PaulBichl/VibePCB-bench-psu/boards/bench-psu/hardware/bench-psu-bom.csv

Qty | Designator | Value | Footprint | MPN | LCSC Part #
14 | C1,C2,C3,C14,C18,C20,C105,C110,C111,C118,C205,C210,C211,C218 | 1uF | tscircuit:capacitor_cap0603 |  | C15849
22 | C4,C11,C17,C19,C21,C22,C104,C112,C114,C115,C116,C117,C119,C120,C204,C212,C214,C215,C216,C217,C219,C220 | 100nF | tscircuit:capacitor_cap0603 |  | C14663
1 | C5 | 4.7nF | tscircuit:capacitor_cap0805 |  | C565695
3 | C6,C25,C26 | 100uF | tscircuit:RVT1V101M0607_100UF_35V | RVT1V101M0607 100UF 35V | C970686
7 | C7,C8,C9,C101,C102,C201,C202 | 10uF | tscircuit:capacitor_cap1206 |  | C13585
3 | C10,C103,C203 | 220nF | tscircuit:capacitor_cap0603 |  | C107083
2 | C12,C13 | 22uF | tscircuit:capacitor_cap0805 |  | C45783
2 | C15,C16 | 10uF | tscircuit:capacitor_cap0805 |  | C15850
10 | C23,C24,C106,C107,C108,C109,C206,C207,C208,C209 | 22uF | tscircuit:capacitor_cap1206 |  | C12891
2 | C113,C213 | 220nF | tscircuit:capacitor_cap0603 |  | C21120
8 | C130,C131,C132,C133,C230,C231,C232,C233 | 33nF | tscircuit:capacitor_cap0603 |  | C21117
1 | D1 | SMBJ22A | tscircuit:SMBJ22A | SMBJ22A | C151920
1 | D2 | ESDA25P35-1U1M | tscircuit:ESDA25P35-1U1M | ESDA25P35-1U1M | C1974707
2 | D13,D23 | SS54 | tscircuit:SS54 | SS54 | C22452
6 | D14,D15,D16,D24,D25,D26 | 1N4148W | tscircuit:1N4148W | 1N4148W | C81598
2 | D101,D201 | KT-0603YG | tscircuit:KT-0603YG | KT-0603YG | C2289
2 | D102,D202 | KT-0603R | tscircuit:KT-0603R | KT-0603R | C2286
2 | ENC1,ENC2 | EC11E15244B2 | tscircuit:EC11E15244B2 | EC11E15244B2 | C470754
1 | J1 | TYPE-C 16PIN 2MD(073) | tscircuit:TYPE-C_16PIN_2MD_073 | TYPE-C 16PIN 2MD(073) | C2765186
1 | J2 | DG301-5.0-04P-14-1000A(H) | tscircuit:DG301-5_0-04P-14-1000A_H | DG301-5.0-04P-14-1000A(H) | C3037697
1 | J3 | PZ254V-11-04P | tscircuit:PZ254V-11-04P | PZ254V-11-04P | C492403
1 | L1 | 6.8µH | tscircuit:FXL0530-6R8-M | FXL0530-6R8-M | C177249
2 | L11,L21 | 15µH | tscircuit:FXL1040-150-M | FXL1040-150-M | C475916
1 | Q1 | AO4407A | tscircuit:AO4407A | AO4407A | C2841482
6 | Q11,Q12,Q14,Q21,Q22,Q24 | MMBT3904(RANGE:100-300) | tscircuit:MMBT3904_RANGE_100-300 | MMBT3904(RANGE:100-300) | C20526
2 | Q13,Q23 | 2N7002 | tscircuit:2N7002 | 2N7002 | C8545
7 | R1,R105,R112,R113,R205,R212,R213 | 1kΩ | tscircuit:resistor_res0603 |  | C21190
1 | R2 | 1MΩ | tscircuit:resistor_res0603 |  | C22935
11 | R3,R4,R5,R107,R109,R120,R126,R207,R209,R220,R226 | 100kΩ | tscircuit:resistor_res0603 |  | C25803
1 | R6 | 24kΩ | tscircuit:resistor_res0603 |  | C23352
7 | R7,R114,R122,R123,R214,R222,R223 | 47kΩ | tscircuit:resistor_res0603 |  | C25819
19 | R9,R10,R13,R106,R108,R110,R115,R116,R117,R119,R124,R206,R208,R210,R215,R216,R217,R219,R224 | 10kΩ | tscircuit:resistor_res0603 |  | C25804
4 | R11,R12,R121,R221 | 4.7kΩ | tscircuit:resistor_res0603 |  | C23162
2 | R101,R201 | 20mΩ | tscircuit:resistor_res2512 |  | C105360
2 | R102,R202 | 120kΩ | tscircuit:resistor_res0603 |  | C25808
2 | R103,R203 | 200kΩ | tscircuit:resistor_res0603 |  | C25811
2 | R104,R204 | 2.2kΩ | tscircuit:resistor_res0603 |  | C4190
2 | R111,R211 | 6.8kΩ | tscircuit:resistor_res0603 |  | C23212
4 | R118,R125,R218,R225 | 330Ω | tscircuit:resistor_res0603 |  | C23138
8 | R130,R131,R132,R133,R230,R231,R232,R233 | 3.3kΩ | tscircuit:resistor_res0603 |  | C22978
2 | SW1,SW2 | TS-1187A-B-A-B | tscircuit:TS-1187A-B-A-B | TS-1187A-B-A-B | C318884
2 | SW13,SW23 | B3F-4055 | tscircuit:B3F-4055 | B3F-4055 | C84931
2 | TH11,TH21 | 10kΩ | tscircuit:NCP18XH103F03RB | NCP18XH103F03RB | C13564
1 | U1 | STUSB4500QTR | tscircuit:STUSB4500QTR | STUSB4500QTR | C2678061
1 | U2 | USBLC6-2SC6 | tscircuit:USBLC6-2SC6 | USBLC6-2SC6 | C2687116
3 | U3,U11,U21 | LMR33630ADDAR | tscircuit:LMR33630ADDAR | LMR33630ADDAR | C841384
1 | U4 | AP2112K-3.3TRG1 | tscircuit:AP2112K-3_3TRG1 | AP2112K-3.3TRG1 | C51118
1 | U5 | ESP32-S3-MINI-1-N8 | tscircuit:ESP32-S3-MINI-1-N8 | ESP32-S3-MINI-1-N8 | C2913206
2 | U6,U7 | TLV9062IDR | tscircuit:TLV9062IDR | TLV9062IDR | C398355
1 | U8 | ESDA25W | tscircuit:ESDA25W | ESDA25W | C2935152
2 | U12,U22 | INA226AIDGSR | tscircuit:INA226AIDGSR | INA226AIDGSR | C49851
2 | U13,U23 | INA181A2IDBVR | tscircuit:INA181A2IDBVR | INA181A2IDBVR | C2058784
