PaulBichl/VibePCB-bench-psu/boards/bench-psu/sim/results/lagsweep.csv

lag_network | vout | phase_margin_deg | min_phase_below_fc_deg | undershoot_mv | tail_after_390us_mv
none | 1.6 | -0.8
none | 3.3 | -14.3
none | 5 | -26.7
none | 12 | -58.0
none | 16 | -70.0
10k / 10 nF | 1.6 | 87.0 | 4.7 | 147.0 | 3.6
10k / 10 nF | 3.3 | 86.6 | -9.9 | 154.9 | 3.6
10k / 10 nF | 5 | 85.9 | -16.2 | 161.5 | 3.7
10k / 10 nF | 12 | 76.6 | -25.8 | 193.2 | 3.9
10k / 10 nF | 16 | 68.7 | -28.0 | 212.9 | 3.9
6.8k / 10 nF | 1.6 | 82.0 | -2.7 | 179.6 | 0.6
6.8k / 10 nF | 3.3 | 86.2 | -16.4 | 190.0 | 1.0
6.8k / 10 nF | 5 | 90.2 | -22.1 | 197.0 | 1.2
6.8k / 10 nF | 12 | 92.9 | -30.8 | 221.8 | 1.4
6.8k / 10 nF | 16 | 89.7 | -32.7 | 240.8 | 1.5
6.8k / 47 nF | 1.6 | 91.6 | 18.6 | 189.7 | 19.3
6.8k / 47 nF | 3.3 | 94.2 | 2.0 | 199.0 | 18.7
6.8k / 47 nF | 5 | 96.8 | -7.0 | 204.3 | 18.6
6.8k / 47 nF | 12 | 96.4 | -23.3 | 223.8 | 18.6
6.8k / 47 nF | 16 | 92.3 | -27.7 | 242.0 | 18.6
6.8k / 220 nF (board) | 1.6 | 93.8 | 34.7 | 192.7 | 9.8
6.8k / 220 nF (board) | 3.3 | 96.0 | 30.8 | 201.7 | 9.6
6.8k / 220 nF (board) | 5 | 98.2 | 25.6 | 206.4 | 9.5
6.8k / 220 nF (board) | 12 | 97.1 | 8.6 | 224.2 | 9.4
6.8k / 220 nF (board) | 16 | 92.8 | 2.4 | 242.2 | 9.3
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
