PaulBichl/VibePCB-bench-psu/boards/bench-psu/sim/results/bode.csv

vout | fb_network | freq_hz | gain_db | phase_deg
1.6 | divider only | 100 | 70.35 | -95.9
1.6 | divider only | 106 | 69.83 | -96.4
1.6 | divider only | 112.3 | 69.31 | -97.0
1.6 | divider only | 118.9 | 68.79 | -97.6
1.6 | divider only | 126 | 68.27 | -98.2
1.6 | divider only | 133.4 | 67.75 | -98.8
1.6 | divider only | 141.3 | 67.22 | -99.5
1.6 | divider only | 149.7 | 66.69 | -100.2
1.6 | divider only | 158.6 | 66.15 | -100.9
1.6 | divider only | 168 | 65.61 | -101.6
1.6 | divider only | 177.9 | 65.07 | -102.4
1.6 | divider only | 188.5 | 64.52 | -103.1
1.6 | divider only | 199.6 | 63.97 | -103.9
1.6 | divider only | 211.5 | 63.41 | -104.8
1.6 | divider only | 224 | 62.85 | -105.6
1.6 | divider only | 237.3 | 62.28 | -106.5
1.6 | divider only | 251.3 | 61.7 | -107.4
1.6 | divider only | 266.2 | 61.11 | -108.4
1.6 | divider only | 282 | 60.52 | -109.3
1.6 | divider only | 298.7 | 59.91 | -110.3
1.6 | divider only | 316.4 | 59.3 | -111.3
1.6 | divider only | 335.2 | 58.68 | -112.3
1.6 | divider only | 355.1 | 58.04 | -113.3
1.6 | divider only | 376.1 | 57.4 | -114.3
1.6 | divider only | 398.4 | 56.74 | -115.4
1.6 | divider only | 422 | 56.08 | -116.4
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
