PaulBichl/VibePCB-bench-psu/boards/bench-psu/sim/results/loadstep.csv

vout | fb_network | t_us | dev_mv
1.6 | divider only | 150.14 | 0.0
1.6 | divider only | 151.14 | 0.0
1.6 | divider only | 152.14 | 0.0
1.6 | divider only | 153.14 | 0.0
1.6 | divider only | 154.14 | 0.0
1.6 | divider only | 155.14 | 0.0
1.6 | divider only | 156.14 | 0.0
1.6 | divider only | 157.14 | 0.0
1.6 | divider only | 158.14 | 0.0
1.6 | divider only | 159.14 | 0.0
1.6 | divider only | 160.14 | 0.0
1.6 | divider only | 161.14 | 0.0
1.6 | divider only | 162.14 | 0.0
1.6 | divider only | 163.14 | 0.0
1.6 | divider only | 164.14 | 0.0
1.6 | divider only | 165.14 | 0.0
1.6 | divider only | 166.14 | 0.0
1.6 | divider only | 167.14 | 0.0
1.6 | divider only | 168.14 | 0.0
1.6 | divider only | 169.14 | 0.0
1.6 | divider only | 170.14 | 0.0
1.6 | divider only | 171.14 | 0.0
1.6 | divider only | 172.14 | 0.0
1.6 | divider only | 173.14 | 0.0
1.6 | divider only | 174.14 | 0.0
1.6 | divider only | 175.14 | 0.0
1.6 | divider only | 176.14 | 0.0
1.6 | divider only | 177.14 | 0.0
1.6 | divider only | 178.14 | 0.0
1.6 | divider only | 179.14 | 0.0
1.6 | divider only | 180.14 | 0.0
1.6 | divider only | 181.14 | 0.0
1.6 | divider only | 182.14 | 0.0
1.6 | divider only | 183.14 | 0.0
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
