PaulBichl/VibePCB-bench-psu/boards/bench-psu/sim/results/loopsummary.csv

vout | fb_network | crossover_khz | phase_margin_deg | min_phase_below_fc_deg | undershoot_mv | overshoot_mv | tail_after_390us_mv | stable
1.6 | divider only | 119.8 | -0.8 | -0.3 |  |  |  | no
1.6 | with lag network | 9.1 | 93.8 | 34.7 | 192.7 | 201.7 | 9.8 | yes
3.3 | divider only | 137.5 | -14.3 | -11.3 |  |  |  | no
3.3 | with lag network | 11.6 | 96.0 | 30.8 | 201.7 | 210.6 | 9.6 | yes
5 | divider only | 154.7 | -26.7 | -23.2 |  |  |  | no
5 | with lag network | 14.6 | 98.2 | 25.6 | 206.4 | 215.4 | 9.5 | yes
12 | divider only | 204.0 | -58.0 | -55.5 |  |  |  | no
12 | with lag network | 28.5 | 97.1 | 8.6 | 224.2 | 233.3 | 9.4 | yes
16 | divider only | 226.7 | -70.0 | -68.7 |  |  |  | no
16 | with lag network | 38.3 | 92.8 | 2.4 | 242.2 | 251.3 | 9.3 | yes
