PaulBichl/VibePCB-bench-psu/boards/bench-psu/hardware/bench-psu-schematic.pdf

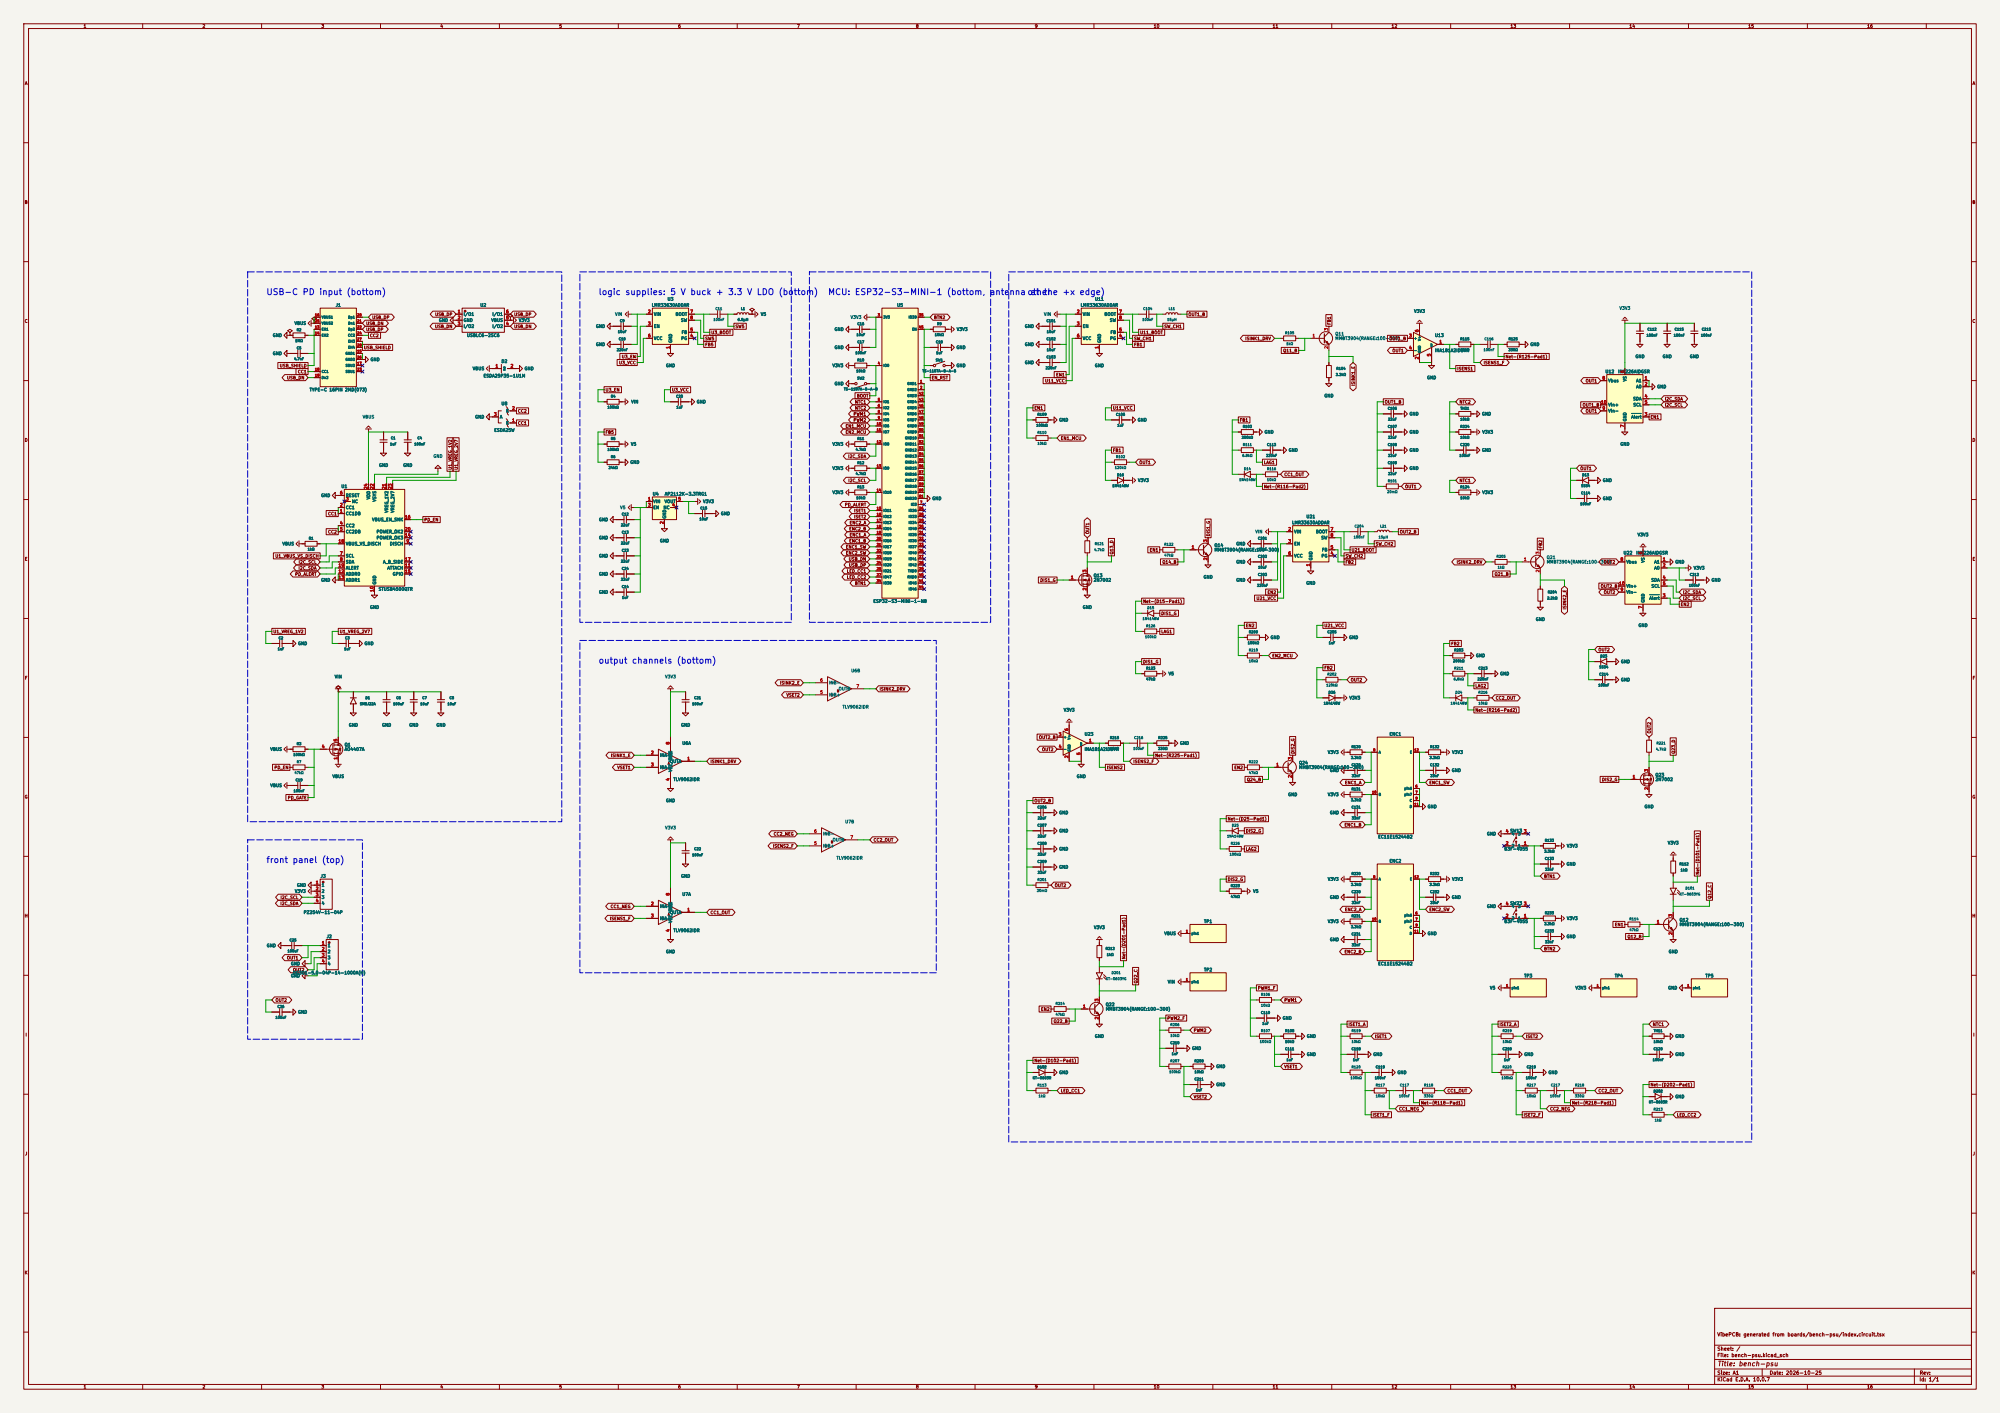
[picture p6: page 1]

VibePCB: generated from boards/bench-psu/index.circuit.tsx

Size: A1 | Rev:
KiCad E.D.A. 10.0.7 | Id: 1/1
