PaulBichl/VibePCB-bench-psu/boards/bench-psu/sim/powerup_ch.cir

* bench-psu rev C: channel power-up and set-point changes through the real VSET network
* run: ngspice -b boards/bench-psu/sim/powerup_ch.cir      (~30 s)
*
* covers: powerup U11 U21
* range: pu_overshoot_pct 0 5 source=house:rules/sim-defaults.toml overshoot_pct (EN at PWM 0, 0 / 1 A; and every set-point step)
* range: pu_settle_ms - 20 source=intent:assumptions "power-up from EN settles within 20 ms" (EN at PWM 0 to 2 % of 1.6 V, incl. the 4 ms soft start)
* range: setpoint_settle_ms - 1000 source=intent:assumptions "set-point changes settle within 1 s" (PWM step to 2 %, via the 2-pole RC)
* range: fb_max_v - 5.5 source=datasheet:LMR33630 SNVSAN3F 7.1 FB abs max 5.5 V (set point 16.6 V -> PWM 0 at no load: the buck cannot sink, the output stays up while the sink current is gone)
* range: vmin_out1 15.77 - source=intent:rail OUT1 16.6 V -5 % (settled output at full PWM through R104 / R106..R108)
*
* Why the sequence matters: the VSET current sink pulls Ic from FB from the moment EN rises, so the output target
* is 1.6 V + 120k * Ic regardless of the converter's soft-start reference. The firmware (README "Firmware duties")
* enables a channel with PWM = 0 (1.6 V, also the reset state), waits for the soft start, then sets the PWM.
*
* Model: the averaged peak-current-mode buck of buck_loop.cir (same assumed internal compensation), its error
* amplifier referenced to a soft-start ramp vref = min(1, t / tss), tss = 4 ms (assumption, SNVSAN3F 3-5 ms typ),
* COMP clamp, PFM variant (no reverse current). Output capacitance at DC bias as in buck_loadpoints.cir.
* Set point as on the board (review board:sims: the deck used to drive the sink current directly and so could not
* see rev B's 15.2 V ceiling): PWM average (0..3.3 V) -> R106 10k -> C110 1 uF -> R107 100k -> VSET (R108 10k,
* C111 1 uF), op-amp + NPN sink Ic = VSET / R104 (2.2k; the op-amp held ideal, its loop is far faster than the RC).
* Lag-capacitor pre-charge as on the board (D15 + R126 from DIS1_G).

.param vt=5 iload=1 tss=4m t1=6m bias=1 tdrop=10 clamp=1
.param duty={(vt - 1.6) / 15}
.param cout={vt < 2 ? 70u : vt < 4 ? 56u : vt < 6 ? 45u : vt < 13 ? 24u : 18u}
.param gm=1m rc=12k cc=4.7n ri=0.1
.param wn={3.14159 * 400k} qs={2 / 3.14159} chn=1n lhn={1 / (wn * wn * chn)} rhn={sqrt(lhn / chn) / qs}

* --- error amplifier against the soft-start reference ---
Bea 0 comp i = gm * (min(1, time / tss) - v(fb))
Roea comp 0 10meg
Rc comp cz {rc}
Cc cz 0 {cc}
Chf comp 0 50p
* COMP clamp (the IC's error amp output is limited; without it the model winds up while FB is above vref)
Dclh comp clh dclamp
Vclh clh 0 0.5
Dcll cll comp dclamp
Vcll cll 0 -0.05
.model dclamp d(is=1e-12 n=0.05)
Bcmd icmd 0 v = min(4.5, max(0, v(comp) / ri))
Rhn icmd hn1 {rhn}
Lhn hn1 ilv {lhn}
Chn ilv 0 {chn}
Bil 0 outb i = v(ilv)
Cout outb co_e {cout}
Rcout co_e 0 0.75m
Rsh outb out 20m
* output bulk at the terminal: C25 (OUT1; C26 on OUT2) 100 uF electrolytic, no DC-bias derating; ESR 0.3 Ohm assumed
* (6.3 x 7.7 mm general-purpose SMD electrolytic, not in the datasheet: ESR-zero ~5 kHz). Checked at 0.05 and 1 Ohm:
* CV phase margin >= 63 deg, CC >= 86 deg, 2 A step <= 323 mV - the result does not hinge on the ESR value.
C25 out cb_e 100u
Resr25 cb_e 0 0.3
* load: iload at the target voltage (resistive), 0 = only the feedback divider and INA inputs
Rload out 0 {iload > 0 ? vt / iload : 1meg}

* --- feedback (R102 / R103, lag R111 + C113), set-point sink ramped by the firmware from t1 over tramp ---
R102 out fb 120k
R103 fb 0 200k
* set point: PWM average from t1 (the firmware sets it after the soft start), filtered as on the board
Vpwm pwm 0 pwl(0 0 {t1} 0 {t1 + 1u} {3.3 * duty} {tdrop} {3.3 * duty} {tdrop + 1u} 0)
R106 pwm pf 10k
C110 pf 0 1u
R107 pf vset 100k
R108 vset 0 10k
C111 vset 0 1u
Efol em 0 vset 0 1
Vis em em2 0
R104 em2 0 2.2k
Bsink fb 0 i = i(Vis)
R111 fb xs 6.8k
C113 xs 0 220n
* lag-capacitor pre-charge while the channel is off (rev C): DIS1_G (the discharge FET's gate, ~4.3 V while EN is
* low, 0.1 V once the NPN Q14 pulls it down at EN) feeds C113 through D15 (1N4148W) + R126 (100k): C113 sits at
* ~1.3 V before EN (R126 swept 68k..180k: overshoot returns above ~165k, settling grows below 100k), so the soft start does not have to charge it through R102. With EN high the diode blocks
* (no offset in operation). bias=0: the rev B network (7.7 V overshoot at every start).
* DIS1_G: 5 V through R123 (47k); Q14 (NPN) pulls it to ~0.1 V once EN is high
V5 v5 0 5
R123 v5 dgn 47k
Ven en 0 pwl(0 0 2u 1)
Snpn dgn 0 en 0 swdis
Rbsel dgn dgb {bias > 0.5 ? 1m : 1e12}
D15 dgb xa dsig
R126 xa xs 100k
.model dsig d(is=2.5n n=1.9 rs=0.6)
* the discharge FET (Q13 + R121 4.7k) holds OUT at 0 V while EN is low
Vctl ctl 0 pwl(0 1 2u 0)
Sdis out dd1 ctl 0 swdis
R121 dd1 0 4.7k
.model swdis sw(vt=0.5 vh=0.1 ron=3 roff=1g)
Cfb fb 0 5p
* FB clamp D16 (1N4148W, FB -> V3V3; review U11:output-voltage): without it FB = 0.625 * OUT (10.4 V at 16.6 V) for
* seconds after a set-point drop or a lost PWM (ESP32 reset), the converter cannot pull the output down
V33 v33 0 3.3
D16 fb dcl dsig
Rclsel dcl v33 {clamp > 0.5 ? 1m : 1e12}

.control
  set noaskquit
  let os_max = 0
  let ts_max = 0
  let ss_max = 0
  let vfull = 0
  echo "power-up at PWM 0 (1.6 V):  Iload | Vmax   overshoot_%  settle_ms"
  foreach i 0 1
    alterparam vt = 1.6
    alterparam iload = $i
    reset
    tran 2u 40m
    meas tran vpk max v(out)
    let os = 100 * (vpk - 1.6) / 1.6
    let os = os > 0 ? os : 0
    let err = abs(v(out) - 1.6) - 0.032
    meas tran tlast when err=0 cross=last
    let ts = tlast * 1000
    echo "  $i | $&vpk $&os $&ts"
    if os > os_max
      let os_max = os
    end
    if ts > ts_max
      let ts_max = ts
    end
    destroy all
  end
  echo "set point (PWM at 6 ms):  Vset Iload | Vend  overshoot_%  settle_ms"
  foreach v 5 16.6
    foreach i 0 1
      alterparam vt = $v
      alterparam iload = $i
      reset
      tran 10u 1.2
      meas tran vend find v(out) at=1.19
      meas tran vpk max v(out)
      let os = 100 * (vpk - vend) / vend
      let os = os > 0 ? os : 0
      let err = abs(v(out) - vend) - 0.02 * vend
      meas tran tlast when err=0 cross=last
      let ss = (tlast - 6m) * 1000
      echo "  $v  $i | $&vend $&os $&ss"
      if os > os_max
        let os_max = os
      end
      if ss > ss_max
        let ss_max = ss
      end
      if $v > 16
        let vfull = vend
      end
      destroy all
    end
  end
  echo "set point 16.6 V -> PWM 0 at 0.4 s, no load:  clamp | FB max"
  let fbmax = 0
  foreach c 0 1
    alterparam vt = 16.6
    alterparam iload = 0
    alterparam tdrop = 0.4
    alterparam clamp = $c
    reset
    tran 10u 1.2
    meas tran fbpk max v(fb) from=0.4 to=1.2
    echo "  $c | $&fbpk"
    if $c > 0
      let fbmax = fbpk
    end
    destroy all
  end
  echo "fb_max_v = $&fbmax"
  echo "pu_overshoot_pct = $&os_max"
  echo "pu_settle_ms = $&ts_max"
  echo "setpoint_settle_ms = $&ss_max"
  echo "vmin_out1 = $&vfull"
.endc
.end
