PaulBichl/VibePCB-bench-psu/boards/bench-psu/hardware/kicad/bench-psu.kicad_pcb

## KiCad design boards/bench-psu/hardware/kicad/bench-psu.kicad_pcb (2026-10-25)

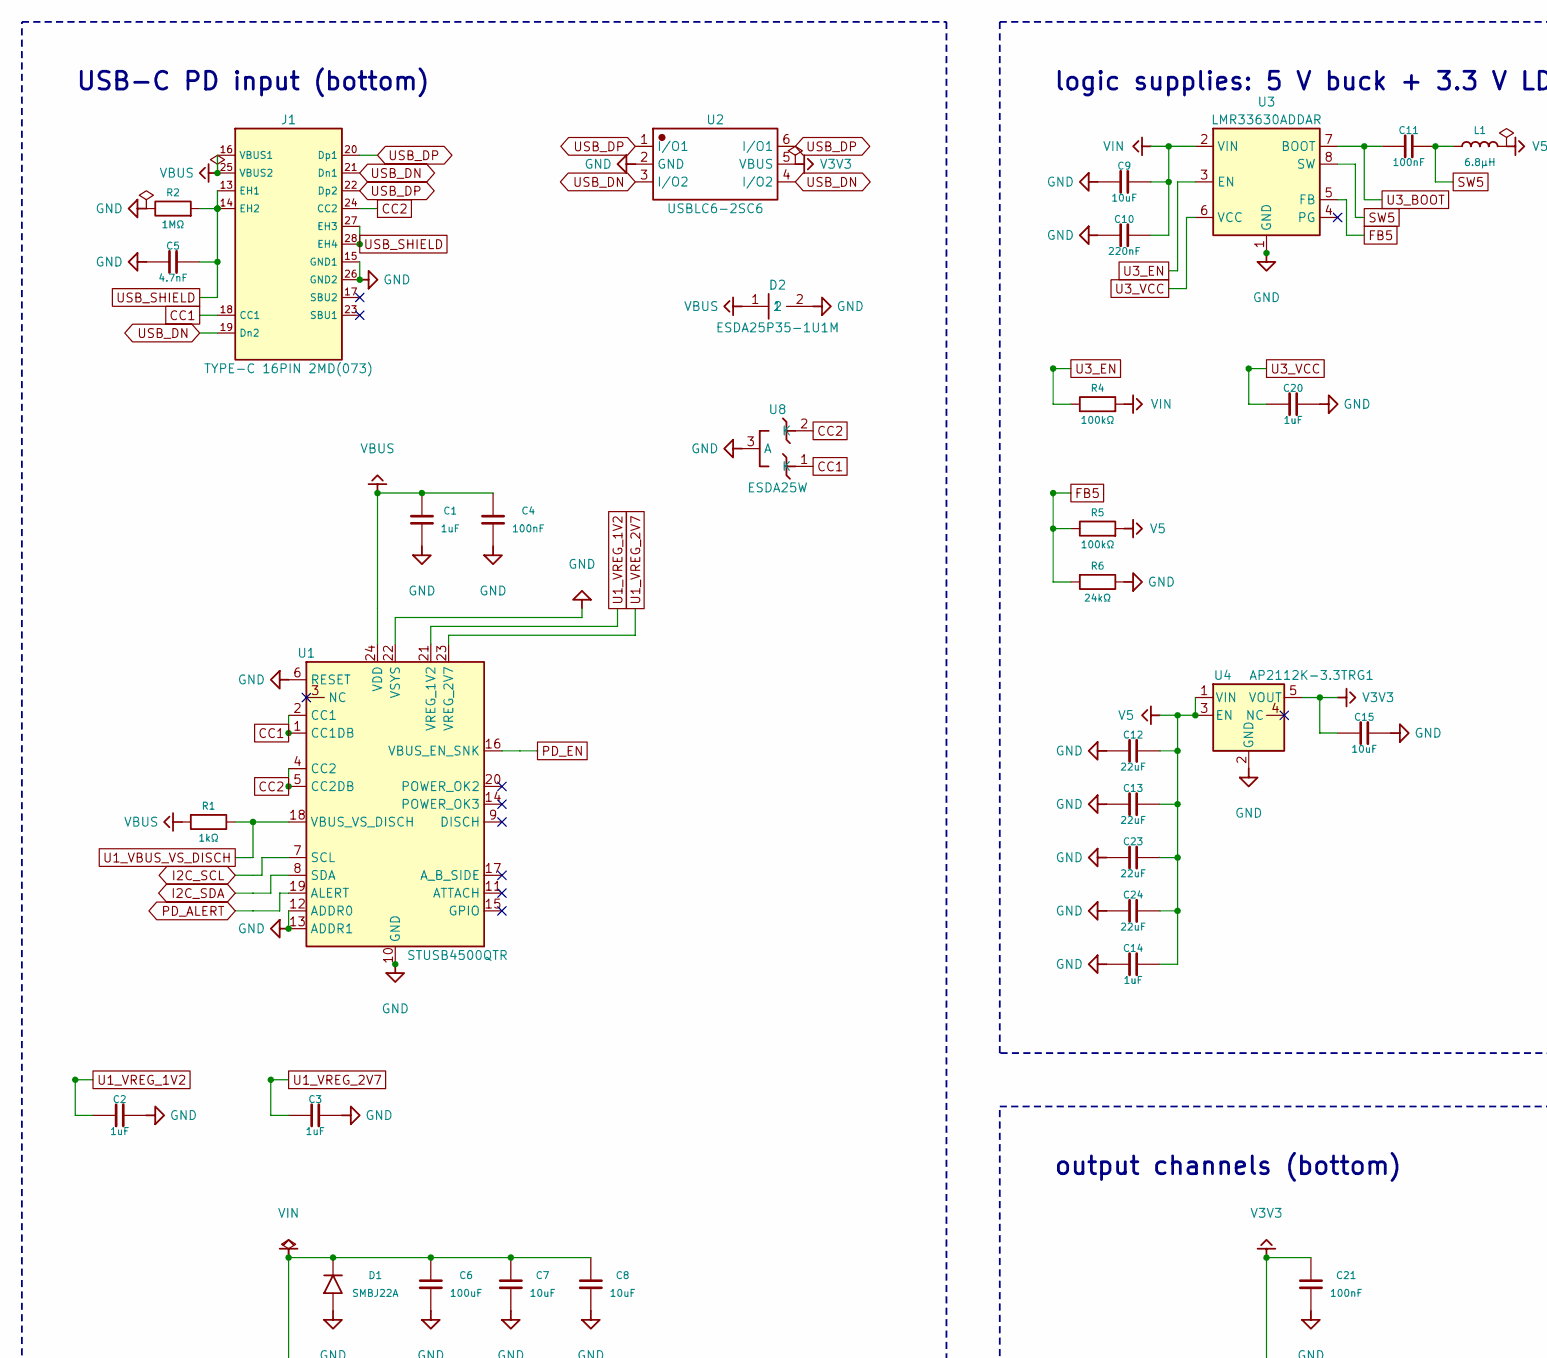
[picture p11: schematic bench-psu.kicad_sch, part in row 1, column 1]

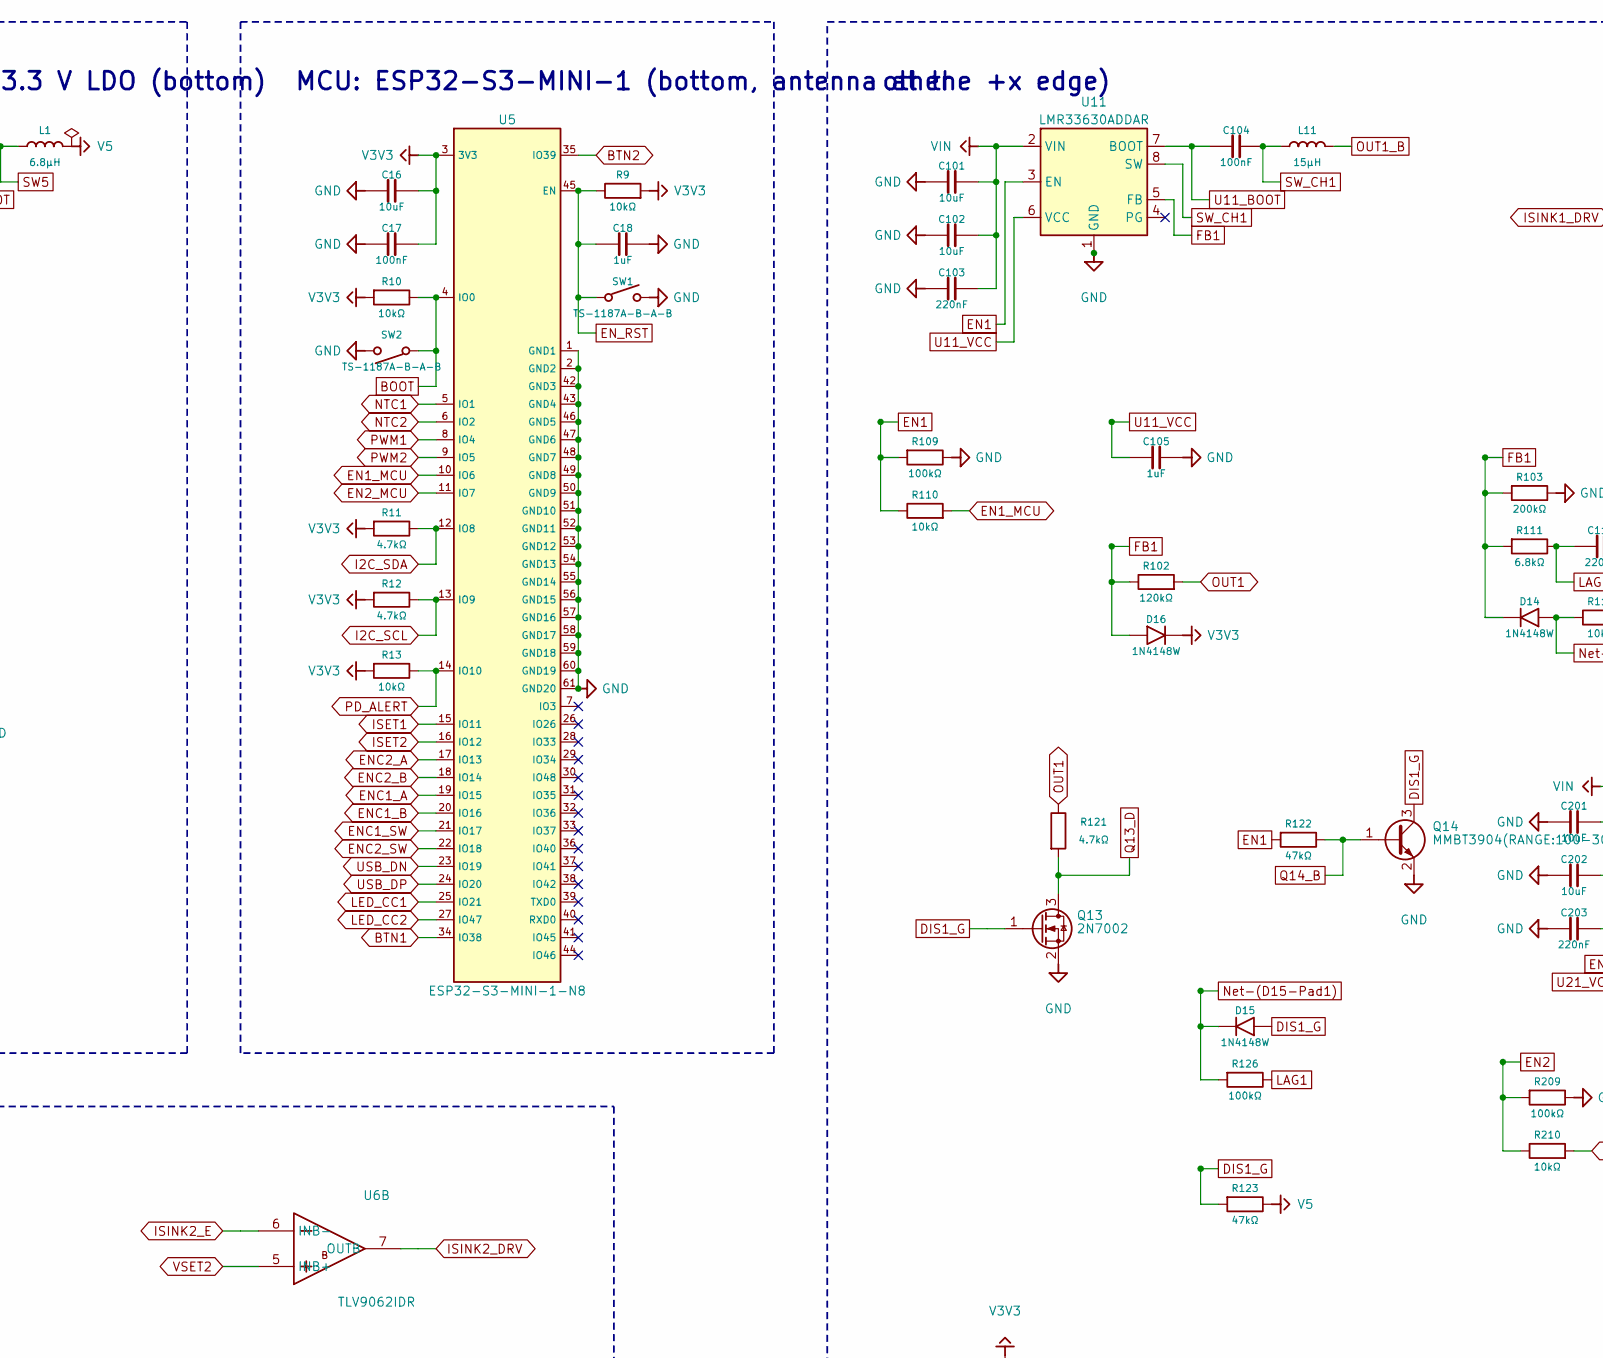
[picture p12: schematic bench-psu.kicad_sch, part in row 1, column 2]

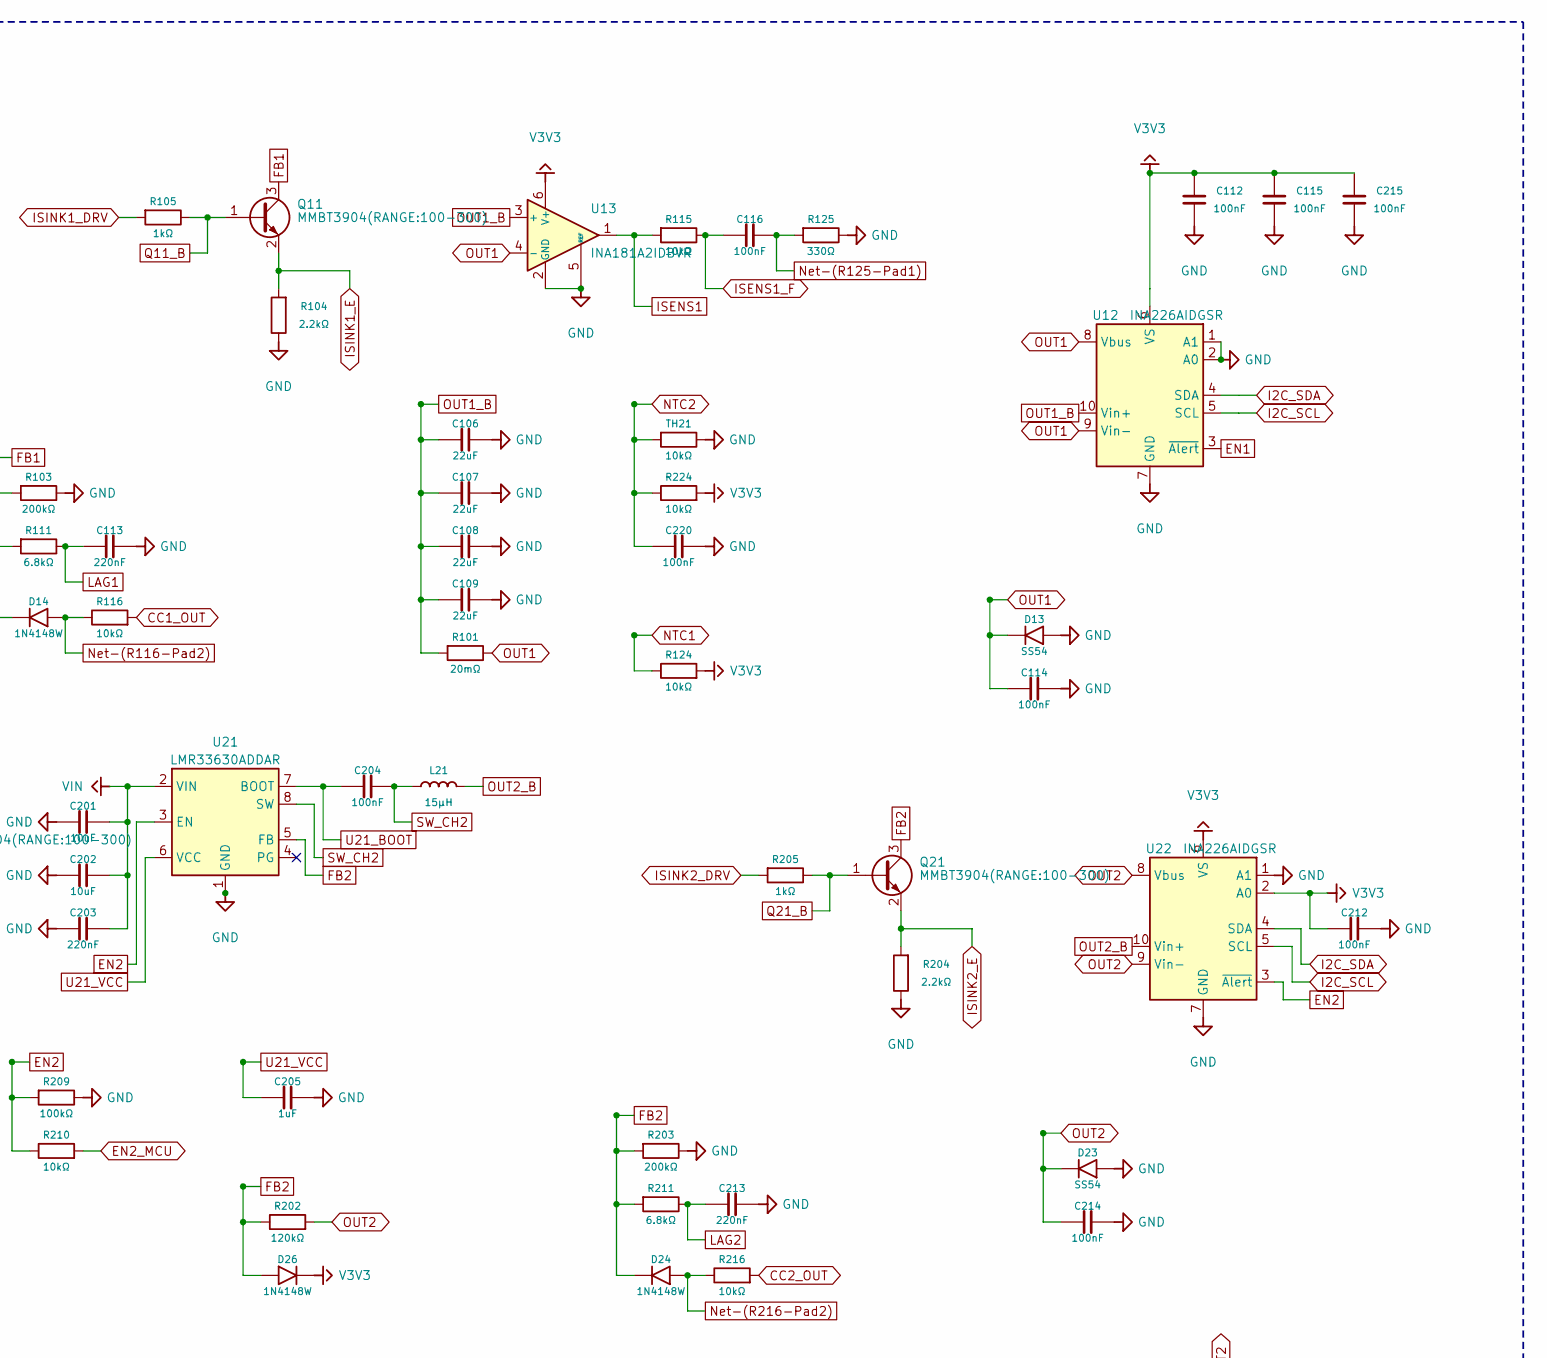
[picture p13: schematic bench-psu.kicad_sch, part in row 1, column 3]

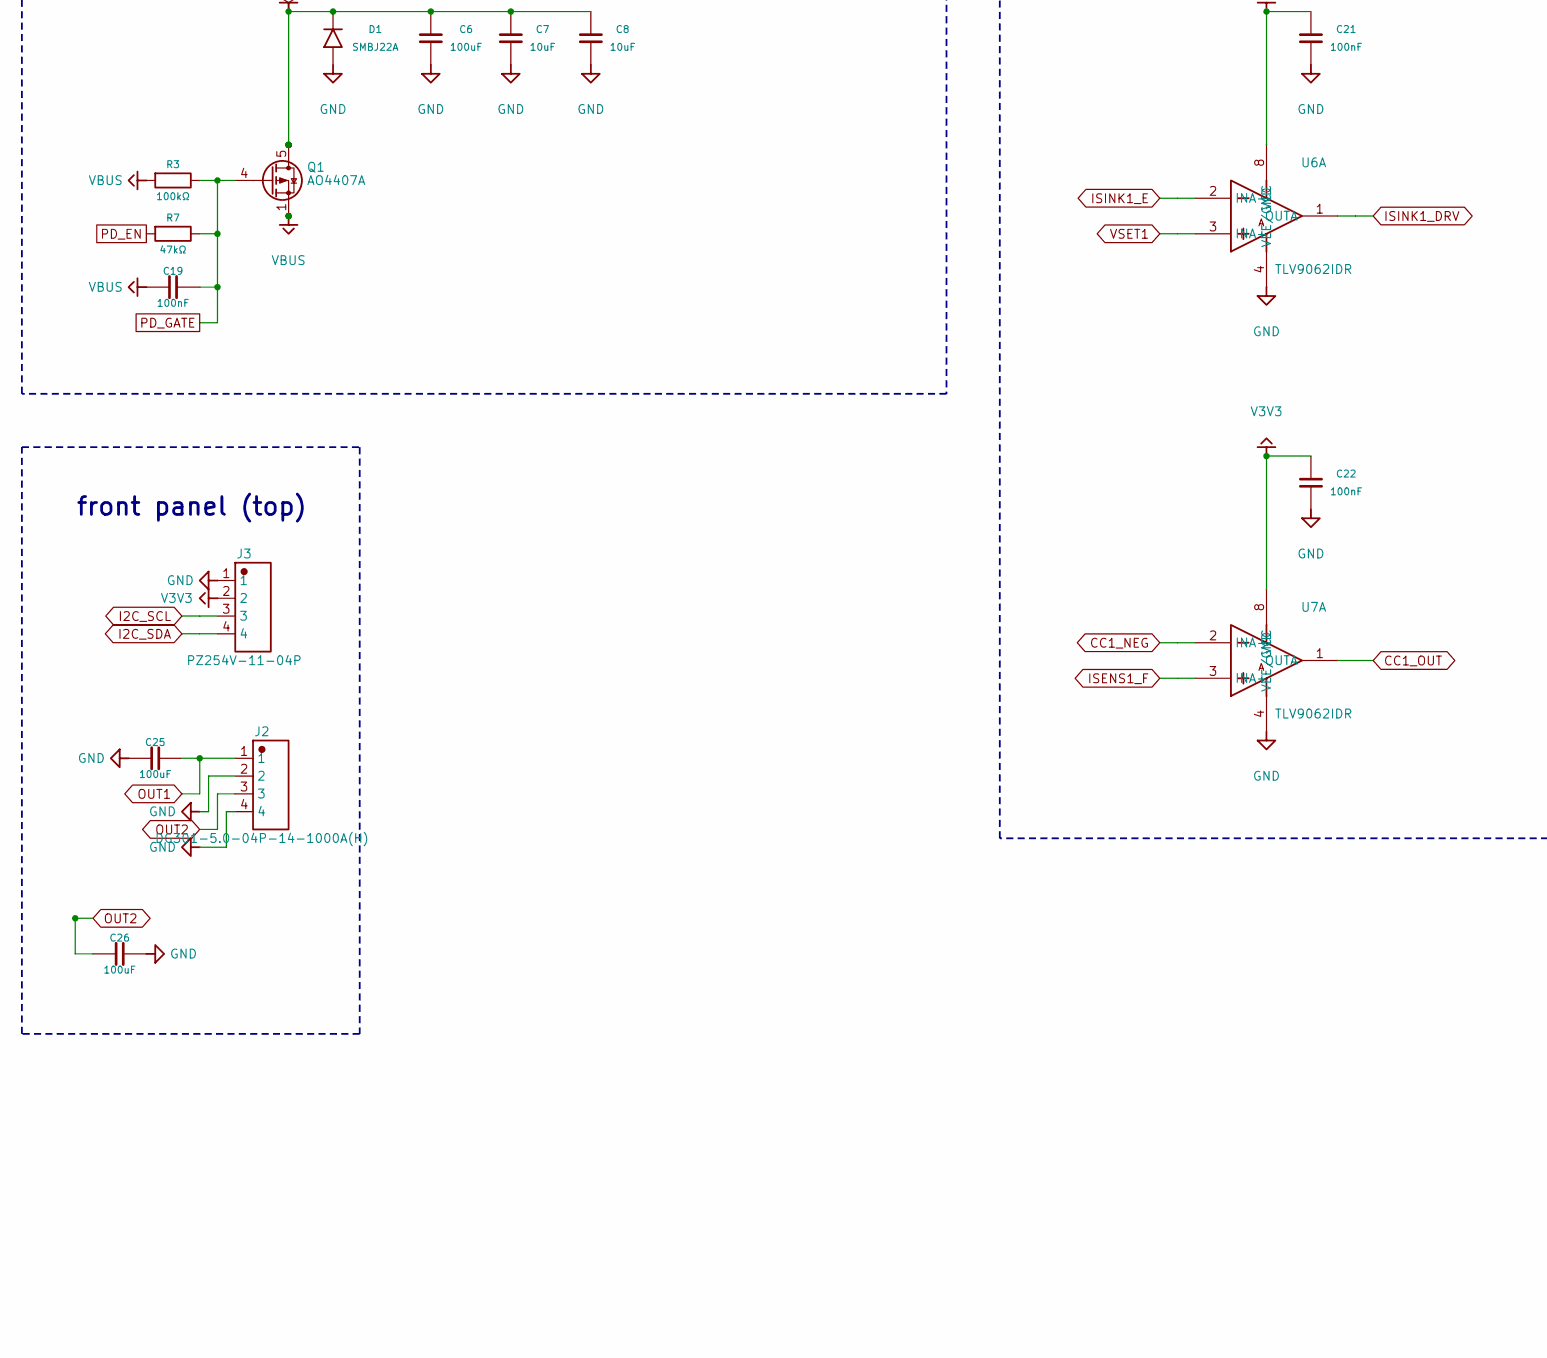
[picture p14: schematic bench-psu.kicad_sch, part in row 2, column 1]

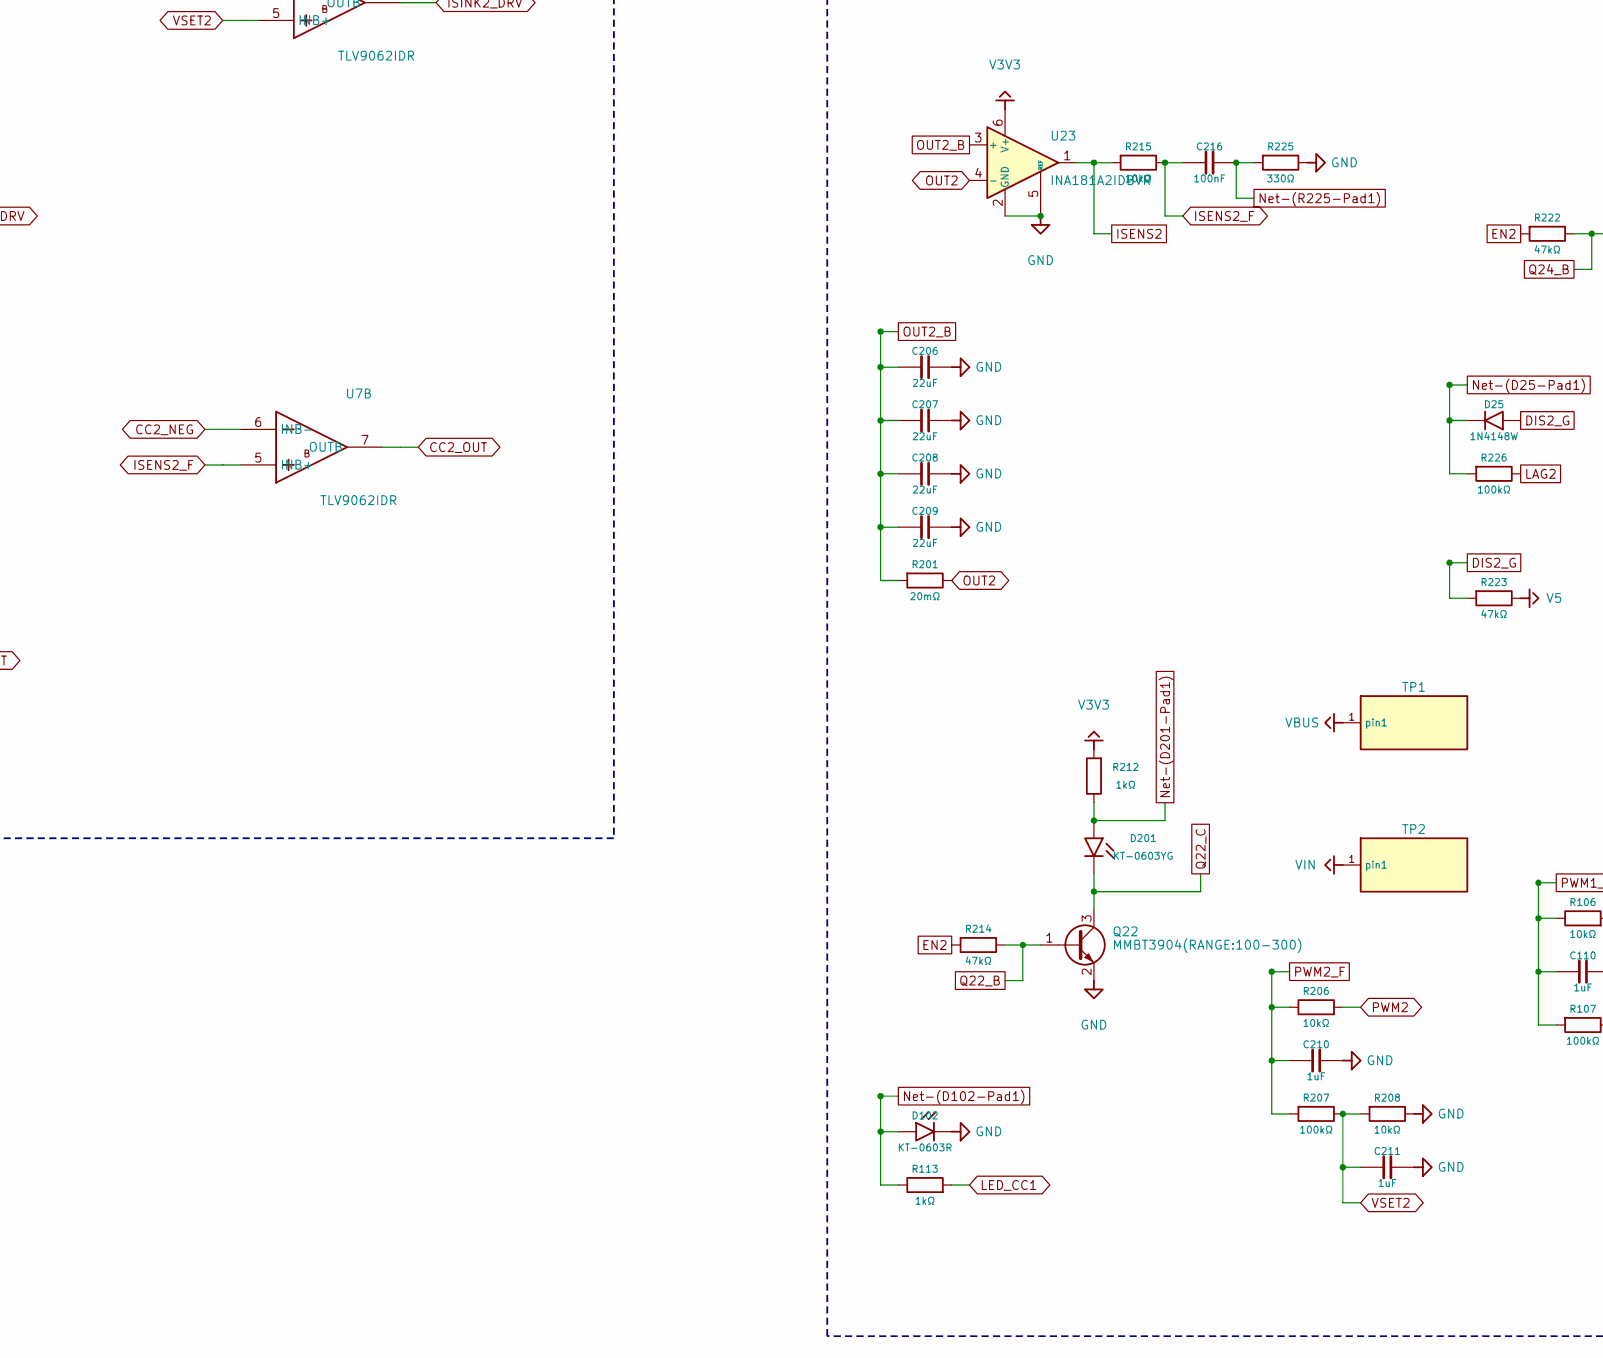
[picture p15: schematic bench-psu.kicad_sch, part in row 2, column 2]

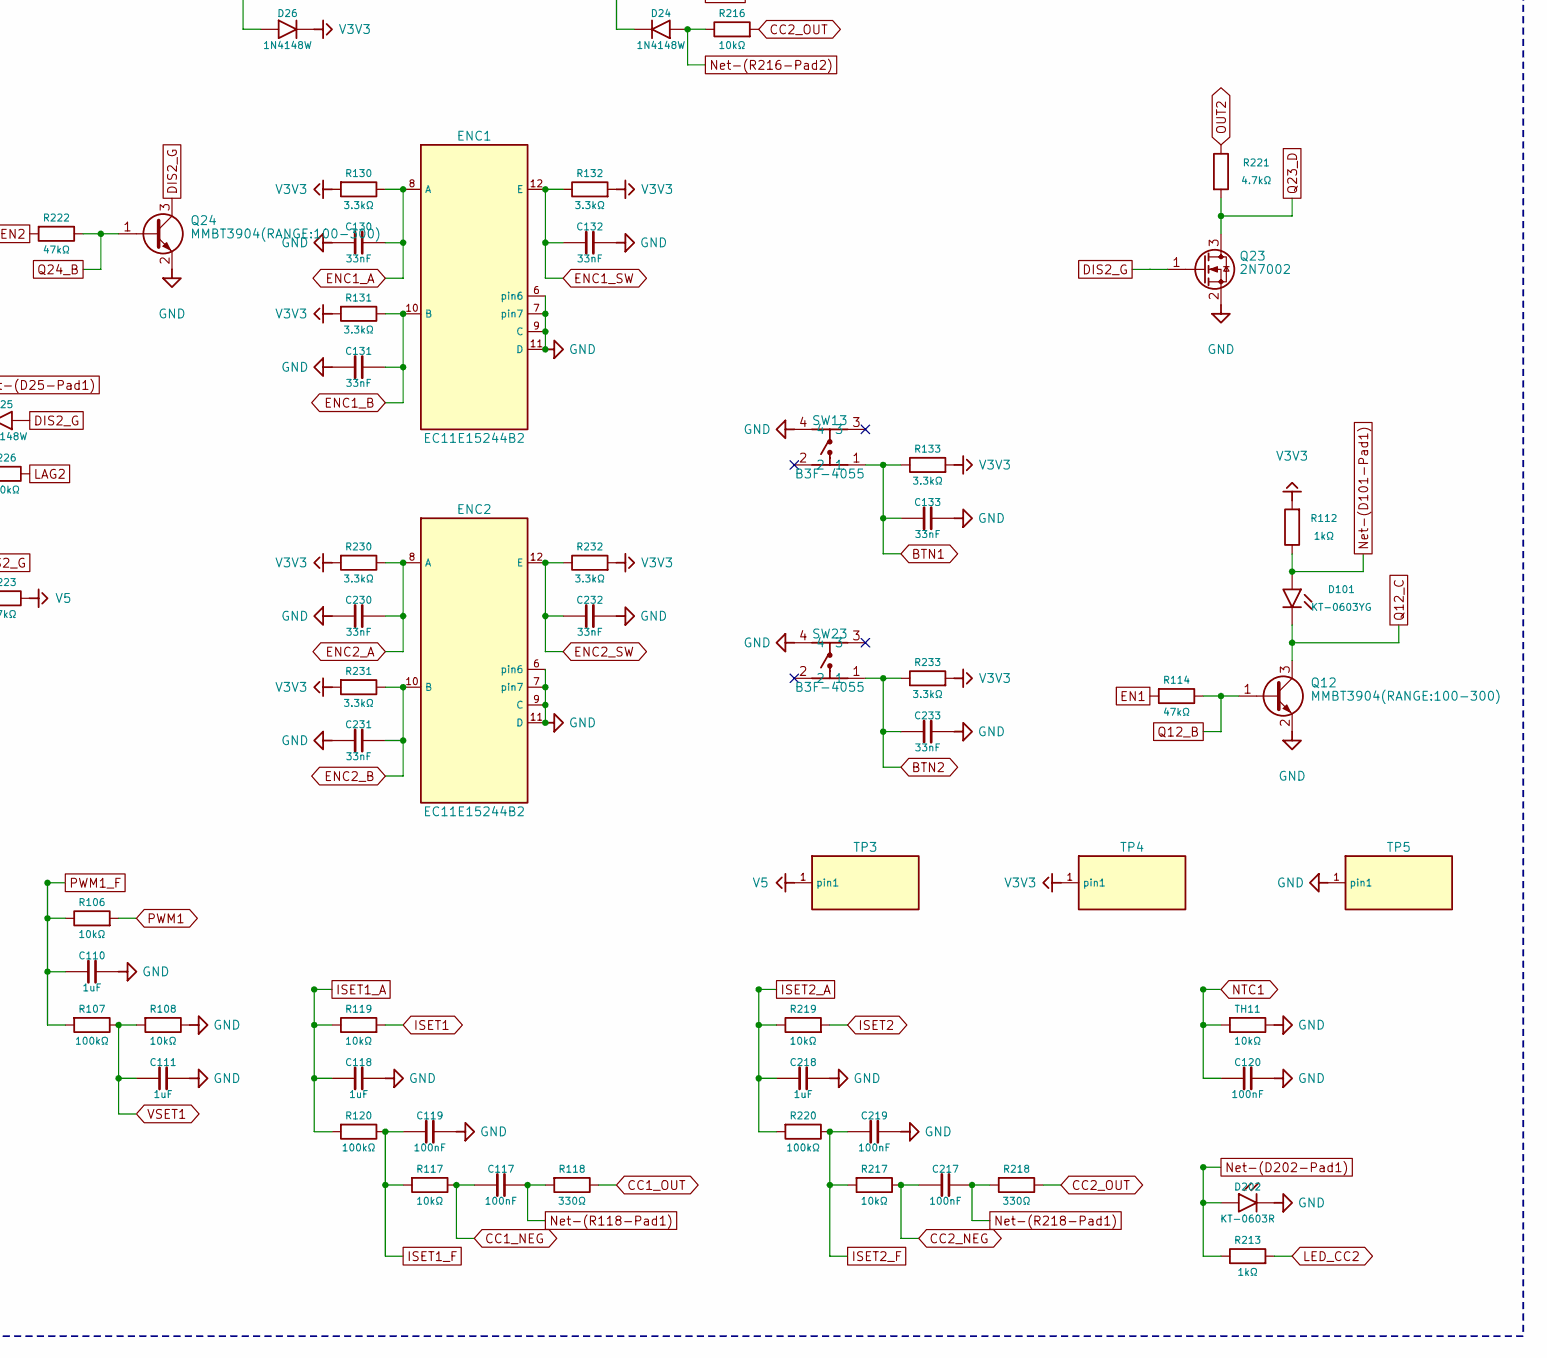
[picture p16: schematic bench-psu.kicad_sch, part in row 2, column 3]

Parts:
C1, C2, C3, C14, C18, C20, C105, C110, C111, C118, C205, C210, C211, C218: 1uF; capacitor_cap0603; LCSC C15849
C4, C11, C17, C19, C21, C22, C104, C112, C114, C115, C116, C117, C119, C120, C204, C212, C214, C215, C216, C217, C219, C220: 100nF; capacitor_cap0603; LCSC C14663
C5: 4.7nF; capacitor_cap0805; LCSC C565695
C6, C25, C26: 100uF; RVT1V101M0607_100UF_35V; MPN RVT1V101M0607 100UF 35V; LCSC C970686
C7, C8, C9, C101, C102, C201, C202: 10uF; capacitor_cap1206; LCSC C13585
C10, C103, C203: 220nF; capacitor_cap0603; LCSC C107083
C12, C13: 22uF; capacitor_cap0805; LCSC C45783
C15, C16: 10uF; capacitor_cap0805; LCSC C15850
C23, C24, C106, C107, C108, C109, C206, C207, C208, C209: 22uF; capacitor_cap1206; LCSC C12891
C113, C213: 220nF; capacitor_cap0603; LCSC C21120
C130, C131, C132, C133, C230, C231, C232, C233: 33nF; capacitor_cap0603; LCSC C21117
D1: SMBJ22A; MPN SMBJ22A; LCSC C151920
D2: ESDA25P35-1U1M; MPN ESDA25P35-1U1M; LCSC C1974707
D13, D23: SS54; MPN SS54; LCSC C22452
D14, D15, D16, D24, D25, D26: 1N4148W; MPN 1N4148W; LCSC C81598
D101, D201: KT-0603YG; MPN KT-0603YG; LCSC C2289
D102, D202: KT-0603R; MPN KT-0603R; LCSC C2286
ENC1, ENC2: EC11E15244B2; MPN EC11E15244B2; LCSC C470754
J1: TYPE-C 16PIN 2MD(073); TYPE-C_16PIN_2MD_073; MPN TYPE-C 16PIN 2MD(073); LCSC C2765186
J2: DG301-5.0-04P-14-1000A(H); DG301-5_0-04P-14-1000A_H; MPN DG301-5.0-04P-14-1000A(H); LCSC C3037697
J3: PZ254V-11-04P; MPN PZ254V-11-04P; LCSC C492403
L1: 6.8µH; FXL0530-6R8-M; MPN FXL0530-6R8-M; LCSC C177249
L11, L21: 15µH; FXL1040-150-M; MPN FXL1040-150-M; LCSC C475916
Q1: AO4407A; MPN AO4407A; LCSC C2841482
Q11, Q12, Q14, Q21, Q22, Q24: MMBT3904(RANGE:100-300); MMBT3904_RANGE_100-300; MPN MMBT3904(RANGE:100-300); LCSC C20526
Q13, Q23: 2N7002; MPN 2N7002; LCSC C8545
R1, R105, R112, R113, R205, R212, R213: 1kΩ; resistor_res0603; LCSC C21190
R2: 1MΩ; resistor_res0603; LCSC C22935
R3, R4, R5, R107, R109, R120, R126, R207, R209, R220, R226: 100kΩ; resistor_res0603; LCSC C25803
R6: 24kΩ; resistor_res0603; LCSC C23352
R7, R114, R122, R123, R214, R222, R223: 47kΩ; resistor_res0603; LCSC C25819
R9, R10, R13, R106, R108, R110, R115, R116, R117, R119, R124, R206, R208, R210, R215, R216, R217, R219, R224: 10kΩ; resistor_res0603; LCSC C25804
R11, R12, R121, R221: 4.7kΩ; resistor_res0603; LCSC C23162
R101, R201: 20mΩ; resistor_res2512; LCSC C105360
R102, R202: 120kΩ; resistor_res0603; LCSC C25808
R103, R203: 200kΩ; resistor_res0603; LCSC C25811
R104, R204: 2.2kΩ; resistor_res0603; LCSC C4190
R111, R211: 6.8kΩ; resistor_res0603; LCSC C23212
R118, R125, R218, R225: 330Ω; resistor_res0603; LCSC C23138
R130, R131, R132, R133, R230, R231, R232, R233: 3.3kΩ; resistor_res0603; LCSC C22978
SW1, SW2: TS-1187A-B-A-B; MPN TS-1187A-B-A-B; LCSC C318884
SW13, SW23: B3F-4055; MPN B3F-4055; LCSC C84931
TH11, TH21: 10kΩ; NCP18XH103F03RB; MPN NCP18XH103F03RB; LCSC C13564
TP1, TP2, TP3, TP4, TP5: test_point_smtpad_circle_d1
U1: STUSB4500QTR; MPN STUSB4500QTR; LCSC C2678061
U2: USBLC6-2SC6; MPN USBLC6-2SC6; LCSC C2687116
U3, U11, U21: LMR33630ADDAR; MPN LMR33630ADDAR; LCSC C841384
U4: AP2112K-3.3TRG1; AP2112K-3_3TRG1; MPN AP2112K-3.3TRG1; LCSC C51118
U5: ESP32-S3-MINI-1-N8; MPN ESP32-S3-MINI-1-N8; LCSC C2913206
U6, U7: TLV9062IDR; MPN TLV9062IDR; LCSC C398355
U8: ESDA25W; MPN ESDA25W; LCSC C2935152
U12, U22: INA226AIDGSR; MPN INA226AIDGSR; LCSC C49851
U13, U23: INA181A2IDBVR; MPN INA181A2IDBVR; LCSC C2058784

Connections:
BOOT: R10.2, SW2.1 (AB), U5.4 (IO0)
BTN1: C133.1, R133.2, SW13.1, U5.34 (IO38)
BTN2: C233.1, R233.2, SW23.1, U5.35 (IO39)
CC1: J1.18 (CC1), U1.1 (CC1DB), U1.2 (CC1), U8.1 (K)
CC1_NEG: C117.1, R117.2, U7.2 (INA-)
CC1_OUT: R116.1, R118.2, U7.1 (OUTA)
CC2: J1.24 (CC2), U1.4 (CC2), U1.5 (CC2DB), U8.2 (K)
CC2_NEG: C217.1, R217.2, U7.6 (INB-)
CC2_OUT: R216.1, R218.2, U7.7 (OUTB)
DIS1_G: D15.2 (anode), Q13.1 (G), Q14.3 (C), R123.1
DIS2_G: D25.2 (anode), Q23.1 (G), Q24.3 (C), R223.1
EN1: R109.1, R110.2, R114.1, R122.1, U11.3 (EN), U12.3 (~Alert)
EN1_MCU: R110.1, U5.10 (IO6)
EN2: R209.1, R210.2, R214.1, R222.1, U21.3 (EN), U22.3 (~Alert)
EN2_MCU: R210.1, U5.11 (IO7)
ENC1_A: C130.1, ENC1.8 (A), R130.2, U5.19 (IO15)
ENC1_B: C131.1, ENC1.10 (B), R131.2, U5.20 (IO16)
ENC1_SW: C132.1, ENC1.12 (E), R132.2, U5.21 (IO17)
ENC2_A: C230.1, ENC2.8 (A), R230.2, U5.17 (IO13)
ENC2_B: C231.1, ENC2.10 (B), R231.2, U5.18 (IO14)
ENC2_SW: C232.1, ENC2.12 (E), R232.2, U5.22 (IO18)
EN_RST: C18.1, R9.2, SW1.1 (AB), U5.45 (EN)
FB1: D14.1 (cathode), D16.2 (anode), Q11.3 (C), R102.2, R103.1, R111.1, U11.5 (FB)
FB2: D24.1 (cathode), D26.2 (anode), Q21.3 (C), R202.2, R203.1, R211.1, U21.5 (FB)
FB5: R5.2, R6.1, U3.5 (FB)
GND: C1.2, C2.2, C3.2, C4.2, C5.2, C6.2, C7.2, C8.2, C9.2, C10.2, C12.2, C13.2, C14.2, C15.2, C16.2, C17.2, C18.2, C20.2, C21.2, C22.2, C23.2, C24.2, C25.2, C26.2, C101.2, C102.2, C103.2, C105.2, C106.2, C107.2, C108.2, C109.2, C110.2, C111.2, C112.2, C113.2, C114.2, C115.2, C118.2, C119.2, C120.2, C130.2, C131.2, C132.2, C133.2, C201.2, C202.2, C203.2, C205.2, C206.2, C207.2, C208.2, C209.2, C210.2, C211.2, C212.2, C213.2, C214.2, C215.2, C218.2, C219.2, C220.2, C230.2, C231.2, C232.2, C233.2, D1.2 (A), D2.2, D13.1 (anode), D23.1 (anode), D102.2, D202.2, ENC1.6, ENC1.7, ENC1.9 (C), ENC1.11 (D), ENC2.6, ENC2.7, ENC2.9 (C), ENC2.11 (D), J1.15 (GND1), J1.26 (GND2), J2.2, J2.4, J3.1, Q12.2 (E), Q13.2 (S), Q14.2 (E), Q22.2 (E), Q23.2 (S), Q24.2 (E), R2.2, R6.2, R103.2, R104.2, R108.2, R109.2, R125.2, R203.2, R204.2, R208.2, R209.2, R225.2, SW1.2 (CD), SW2.2 (CD), SW13.4, SW23.4, TH11.2, TH21.2, TP5.1, U1.6 (RESET), U1.10 (GND), U1.12 (ADDR0), U1.13 (ADDR1), U1.22 (VSYS), U1.25 (GND), U2.2 (GND), U3.1 (GND), U3.9 (GND), U4.2 (GND), U5.1 (GND1), U5.2 (GND2), U5.42 (GND3), U5.43 (GND4), U5.46 (GND5), U5.47 (GND6), U5.48 (GND7), U5.49 (GND8), U5.50 (GND9), U5.51 (GND10), U5.52 (GND11), U5.53 (GND12), U5.54 (GND13), U5.55 (GND14), U5.56 (GND15), U5.57 (GND16), U5.58 (GND17), U5.59 (GND18), U5.60 (GND19), U5.61 (GND20), U6.4 (VEE/GND), U7.4 (VEE/GND), U8.3 (A), U11.1 (GND), U11.9 (GND), U12.1 (A1), U12.2 (A0), U12.7 (GND), U13.2 (GND), U13.5 (REF), U21.1 (GND), U21.9 (GND), U22.1 (A1), U22.7 (GND), U23.2 (GND), U23.5 (REF)
I2C_SCL: J3.3, R12.2, U1.7 (SCL), U5.13 (IO9), U12.5 (SCL), U22.5 (SCL)
I2C_SDA: J3.4, R11.2, U1.8 (SDA), U5.12 (IO8), U12.4 (SDA), U22.4 (SDA)
ISENS1: R115.1, U13.1
ISENS1_F: C116.1, R115.2, U7.3 (INA+)
ISENS2: R215.1, U23.1
ISENS2_F: C216.1, R215.2, U7.5 (INB+)
ISET1: R119.1, U5.15 (IO11)
ISET1_A: C118.1, R119.2, R120.1
ISET1_F: C119.1, R117.1, R120.2
ISET2: R219.1, U5.16 (IO12)
ISET2_A: C218.1, R219.2, R220.1
ISET2_F: C219.1, R217.1, R220.2
ISINK1_DRV: R105.1, U6.1 (OUTA)
ISINK1_E: Q11.2 (E), R104.1, U6.2 (INA-)
ISINK2_DRV: R205.1, U6.7 (OUTB)
ISINK2_E: Q21.2 (E), R204.1, U6.6 (INB-)
LAG1: C113.1, R111.2, R126.2
LAG2: C213.1, R211.2, R226.2
LED_CC1: R113.1, U5.25 (IO21)
LED_CC2: R213.1, U5.27 (IO47)
NTC1: C120.1, R124.2, TH11.1, U5.5 (IO1)
NTC2: C220.1, R224.2, TH21.1, U5.6 (IO2)
unnamed: D15.1 (cathode), R126.1
unnamed: D25.1 (cathode), R226.1
unnamed: D101.1, R112.2
unnamed: D102.1, R113.2
unnamed: D201.1, R212.2
unnamed: D202.1, R213.2
unnamed: D14.2 (anode), R116.2
unnamed: C117.2, R118.1
unnamed: C116.2, R125.1
unnamed: D24.2 (anode), R216.2
unnamed: C217.2, R218.1
unnamed: C216.2, R225.1
OUT1: C25.1, C114.1, D13.2 (cathode), J2.1, R101.2, R102.1, R121.2, U12.8 (Vbus), U12.9 (Vin-), U13.4 (-)
OUT1_B: C106.1, C107.1, C108.1, C109.1, L11.2, R101.1, U12.10 (Vin+), U13.3 (+)
OUT2: C26.1, C214.1, D23.2 (cathode), J2.3, R201.2, R202.1, R221.2, U22.8 (Vbus), U22.9 (Vin-), U23.4 (-)
OUT2_B: C206.1, C207.1, C208.1, C209.1, L21.2, R201.1, U22.10 (Vin+), U23.3 (+)
PD_ALERT: R13.2, U1.19 (ALERT), U5.14 (IO10)
PD_EN: R7.1, U1.16 (VBUS_EN_SNK)
PD_GATE: C19.2, Q1.4 (G), R3.2, R7.2
PWM1: R106.1, U5.8 (IO4)
PWM1_F: C110.1, R106.2, R107.1
PWM2: R206.1, U5.9 (IO5)
PWM2_F: C210.1, R206.2, R207.1
Q11_B: Q11.1 (B), R105.2
Q12_B: Q12.1 (B), R114.2
Q12_C: D101.2, Q12.3 (C)
Q13_D: Q13.3 (D), R121.1
Q14_B: Q14.1 (B), R122.2
Q21_B: Q21.1 (B), R205.2
Q22_B: Q22.1 (B), R214.2
Q22_C: D201.2, Q22.3 (C)
Q23_D: Q23.3 (D), R221.1
Q24_B: Q24.1 (B), R222.2
SW5: C11.2, L1.1, U3.8 (SW)
SW_CH1: C104.2, L11.1, U11.8 (SW)
SW_CH2: C204.2, L21.1, U21.8 (SW)
U1_VBUS_VS_DISCH: R1.2, U1.18 (VBUS_VS_DISCH)
U1_VREG_1V2: C2.1, U1.21 (VREG_1V2)
U1_VREG_2V7: C3.1, U1.23 (VREG_2V7)
U3_BOOT: C11.1, U3.7 (BOOT)
U3_EN: R4.2, U3.3 (EN)
U3_VCC: C20.1, U3.6 (VCC)
U11_BOOT: C104.1, U11.7 (BOOT)
U11_VCC: C105.1, U11.6 (VCC)
U21_BOOT: C204.1, U21.7 (BOOT)
U21_VCC: C205.1, U21.6 (VCC)
USB_DN: J1.19 (Dn2), J1.21 (Dn1), U2.3 (I/O2), U2.4 (I/O2), U5.23 (IO19)
USB_DP: J1.20 (Dp1), J1.22 (Dp2), U2.1 (I/O1), U2.6 (I/O1), U5.24 (IO20)
USB_SHIELD: C5.1, J1.13 (EH1), J1.14 (EH2), J1.27 (EH3), J1.28 (EH4), R2.1
V3V3: C15.1, C16.1, C17.1, C21.1, C22.1, C112.1, C115.1, C212.1, C215.1, D16.1 (cathode), D26.1 (cathode), J3.2, R9.1, R10.1, R11.1, R12.1, R13.1, R112.1, R124.1, R130.1, R131.1, R132.1, R133.1, R212.1, R224.1, R230.1, R231.1, R232.1, R233.1, TP4.1, U2.5 (VBUS), U4.5 (VOUT), U5.3 (3V3), U6.8 (VCC), U7.8 (VCC), U12.6 (VS), U13.6 (V+), U22.2 (A0), U22.6 (VS), U23.6 (V+)
V5: C12.1, C13.1, C14.1, C23.1, C24.1, L1.2, R5.1, R123.2, R223.2, TP3.1, U4.1 (VIN), U4.3 (EN)
VBUS: C1.1, C4.1, C19.1, D2.1, J1.16 (VBUS1), J1.25 (VBUS2), Q1.1 (S), Q1.2 (S), Q1.3 (S), R1.1, R3.1, TP1.1, U1.24 (VDD)
VIN: C6.1, C7.1, C8.1, C9.1, C10.1, C101.1, C102.1, C103.1, C201.1, C202.1, C203.1, D1.1 (C), Q1.5 (D), Q1.6 (D), Q1.7 (D), Q1.8 (D), R4.1, TP2.1, U3.2 (VIN), U11.2 (VIN), U21.2 (VIN)
VSET1: C111.1, R107.2, R108.1, U6.3 (INA+)
VSET2: C211.1, R207.2, R208.1, U6.5 (INB+)

Notes on the sheet:
USB-C PD input (bottom)
logic supplies: 5 V buck + 3.3 V LDO (bottom)
MCU: ESP32-S3-MINI-1 (bottom, antenna at the +x edge)
other
output channels (bottom)
front panel (top)

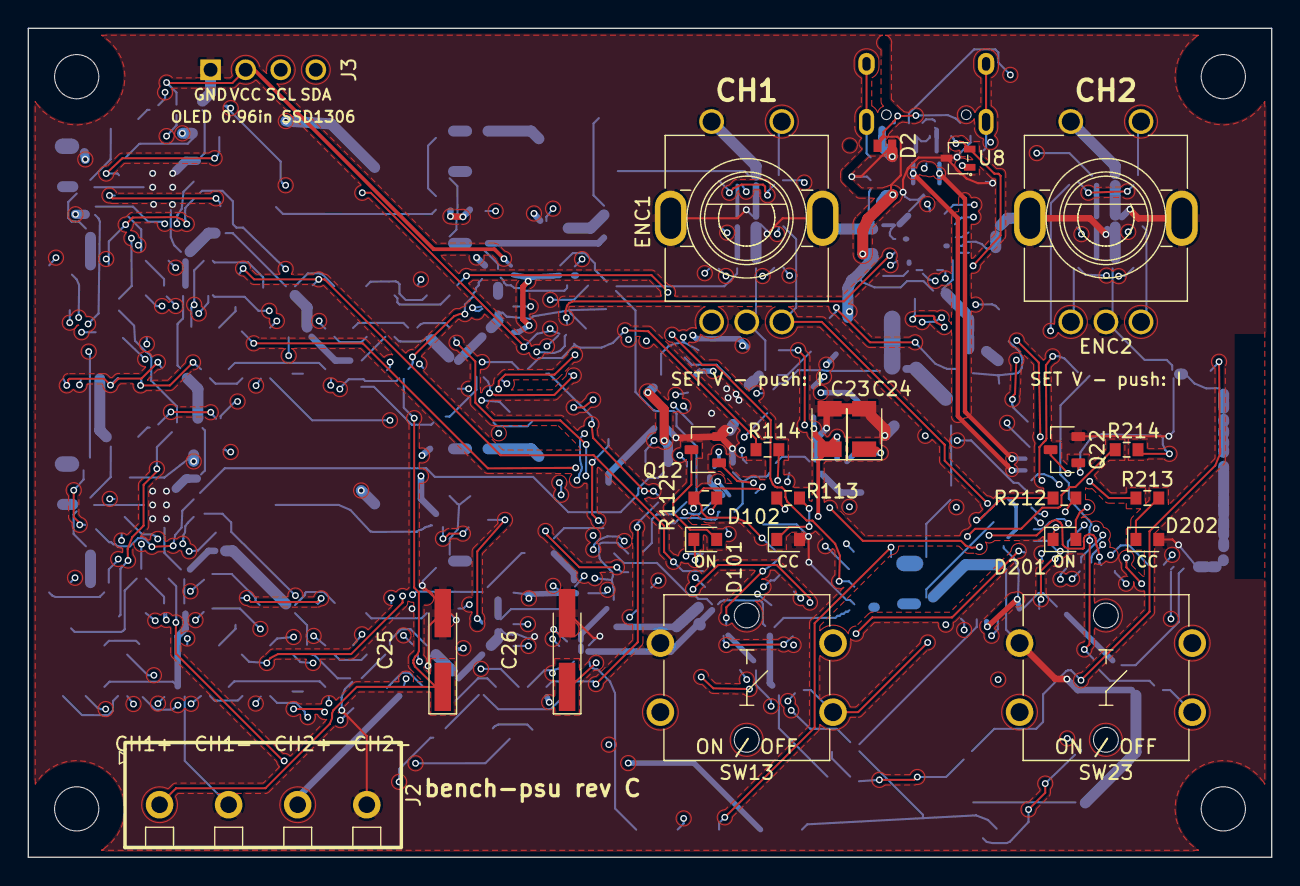
[picture p17: board bench-psu.kicad_pcb from above]

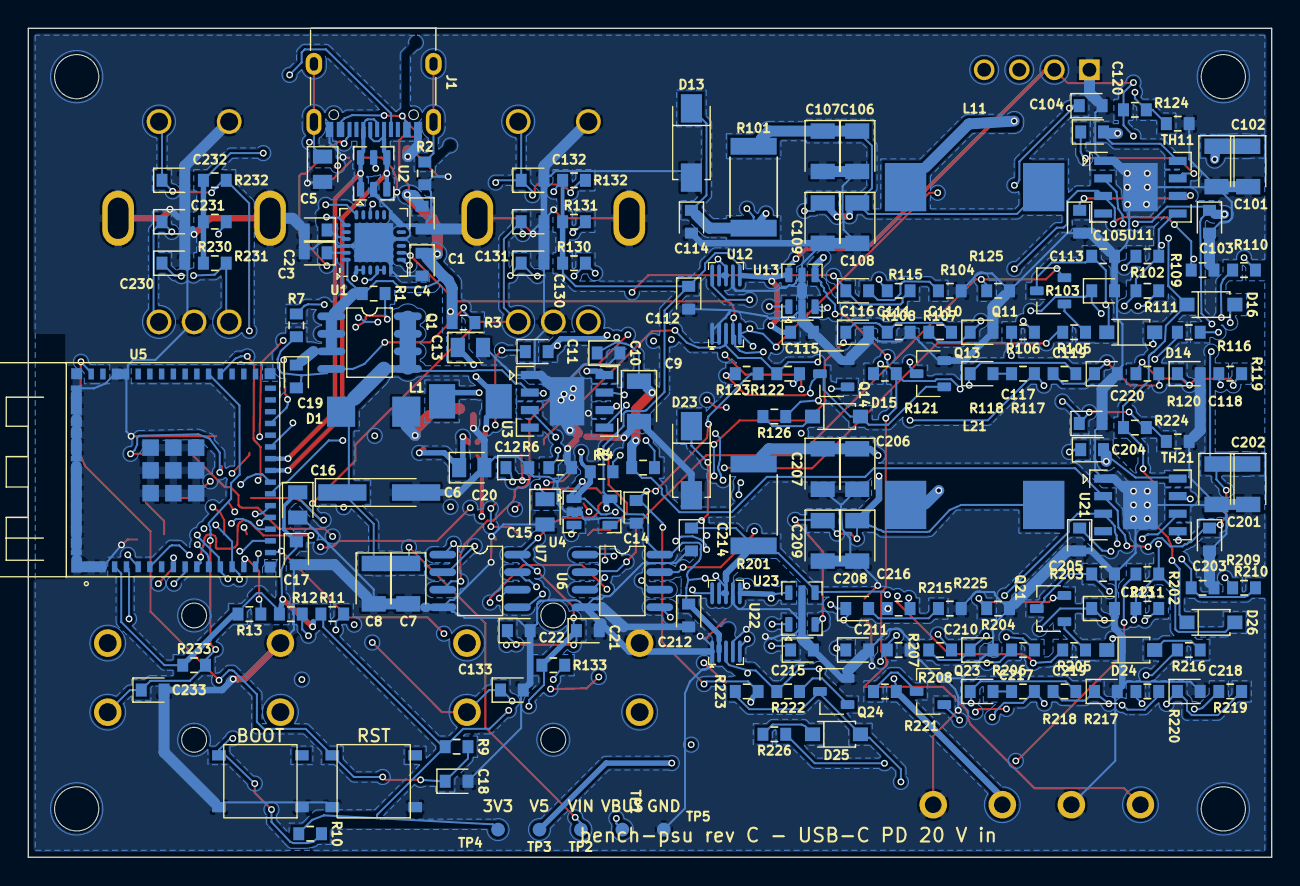
[picture p18: board bench-psu.kicad_pcb from below]

Board: 4 copper layers, 90.0 x 60.0 mm, 202 parts (178 on the bottom side), 103 nets.
