PaulBichl/VibePCB-bench-psu/(commit log)

2026-10-19 bench-psu: USB-C PD 2-channel programmable bench supply (2x LMR51635 buck, ESP32-S3, INA219); check passes
2026-10-19 README: design decisions, pin map, firmware duties, open items
2026-10-19 Add review set and fab files (schematic, top/bottom views, layout, KiCad project, BOM, gerbers, CPL); link from README
    [bench-psu-bom.csv, bench-psu.kicad_pcb, bench-psu.kicad_sch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]
2026-10-22 bench-psu rev B: LMR33630 bucks, INA226 with hardware over-current trip, fail-safe FB current sink
    - Converter: LMR33630A (400 kHz, 3 A) per channel and for the 5 V rail; FXL1040 10 uH inductor
    - Voltage set: TLV9062 + NPN current sink on FB (1.6 V at 0 V/floating PWM, 16.6 V max)
    - Loop compensation: 6.8k + 220 nF lag network on FB (simulated PM 52-75 deg)
    - Measurement: INA226 on 20 mR shunt; ALERT pulls buck EN low (hardware trip)
    - Input: SMBJ22A TVS, gate divider for AO4407A Vgs, SMD electrolytic
    - Add SPICE sim decks, scripts, plots (boards/bench-psu/sim)
    - Regenerate review set and fab files; update README
    [bench-psu-bom.csv, bench-psu.kicad_pcb, bench-psu.kicad_sch, bode.csv, lagsweep.csv, loadpoints.csv, loadstep.csv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]
2026-10-22 bench-psu: output status LEDs, silkscreen pass, bring-up guide
    - Per channel ON LED (KT-0603YG, driven from the buck EN node through an NPN: shows the
    hardware state, dark after an INA226 trip) and OC LED (KT-0603R on IO21 / IO47)
    - Silkscreen: LED functions, header pin labels at fab-legal size, RST/BOOT and the title
    moved off parts and pads, rail probe points (VIN, 5V, 3V3), PD input label, pin and
    I2C-address summary on the back
    - README: bring-up guide (unpowered checks, logic at 5 V, firmware/I2C, channels at 5 V,
    20 V), LED design notes, pin map
    - Republished review set; findings.toml from the new check verification
    hardware/fab (gerbers, CPL) is NOT regenerated and still show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
    [bench-psu-bom.csv, bench-psu.kicad_pcb, bench-psu.kicad_sch]
2026-10-23 bench-psu rev C: front-panel board (90 x 60 mm, parts on both sides), CV/CC, controls, OLED, mounting holes, thermal vias, NTCs
    - top = front panel: SSD1306 OLED module, per channel EC11 encoder + ON/OFF button, ON / CC LEDs, terminal;
    bottom = all electronics; 4 x M3
    - constant-current loop: INA181 + differential PI integrator into FB (sim/cc_loop.cir: PM >= 90 deg)
    - lag-capacitor pre-charge while off: rev B overshot to ~7.7 V at every enable (sim/powerup_ch.cir)
    - output discharge, SS54 reverse diode, 100 nF at the terminal, NTC per converter, thermal via grids
    - intent.toml, five sim decks run by check (all pass), findings accepted with reasons
    - check passes (0 DRC errors, 0 sharp ben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
2026-10-23 rev C after the first design review: Vout_max 16.6 V (R104/R204 2.2k), 15 uH / 7 A channel inductors, 6.8 uH / 4 A logic inductor + 2 x 22 uF, 4.7k discharge, VBUS TVS + CC ESD; check passes
    Review (reviewer agent, 178 items: 155 ok, 15 issues, 8 unknown): fixed what was right, the rest accepted with
    reasons in findings.toml. Placement picked from six parallel variants (R5 0.3 mm down routes clean).
2026-10-23 powerup_ch.cir through the real VSET network (R104/R106-R108/C110/C111, bound to the board): catches a voltage ceiling; vmin_out1 16.60 V
2026-10-24 rev C after the second design review: 220 nF 50 V HF input caps (C10/C103/C203), 100 uF output bulk C25/C26 (CV phase margin >= 63 deg for ESR 0.05..1 Ohm), 10 nF -> C100042 (C57112 out of stock), ti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
2026-10-24 rev C after the third review: encoder / button pull-ups 3.3k + 33 nF (1 mA contact current, EC11 minimum); remaining review items accepted with reasons; bring-up: OLED header order, loop-gain measure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
2026-10-24 rev C after the fourth review: FB clamps D16/D26 (1N4148W FB -> V3V3: 10.3 V -> 3.8 V after a set-point drop, powerup_ch fb_max_v), D2 polarity verified, 3 A budget accepted (firmware caps ISET at 3.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
2026-10-25 rev C after reviews 5 and 6: C5 4.7 nF 1 kV 0805 (shell ESD), USB D+/D- as a 90 Ohm pair on the top layer (fixed pcbPath, USBLC6 channels swapped), C5 at (23.7, 19.8); intent: hard-short hiccup; chec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
2026-10-25 clean up after rev C: hardware/ republished from rev C (stale rev B fab/ removed), sim results and loop plots regenerated from the rev C decks (rev B load-point/switching data dropped), README and si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
    [bench-psu-bom.csv, bench-psu.kicad_pcb, bench-psu.kicad_sch, bode.csv, lagsweep.csv, loadpoints.csv, loadstep.csv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]
2026-10-25 hardware/ republished: USB pair vias 0.3 mm drill (standard price class; VibePCB widen_thin_vias + 0.3 mm via rule)
    [bench-psu.kicad_pcb, bench-psu.kicad_sch]
